Tinkerforge/multi-touch-bricklet/hardware/multi-touch-schematic.pdf

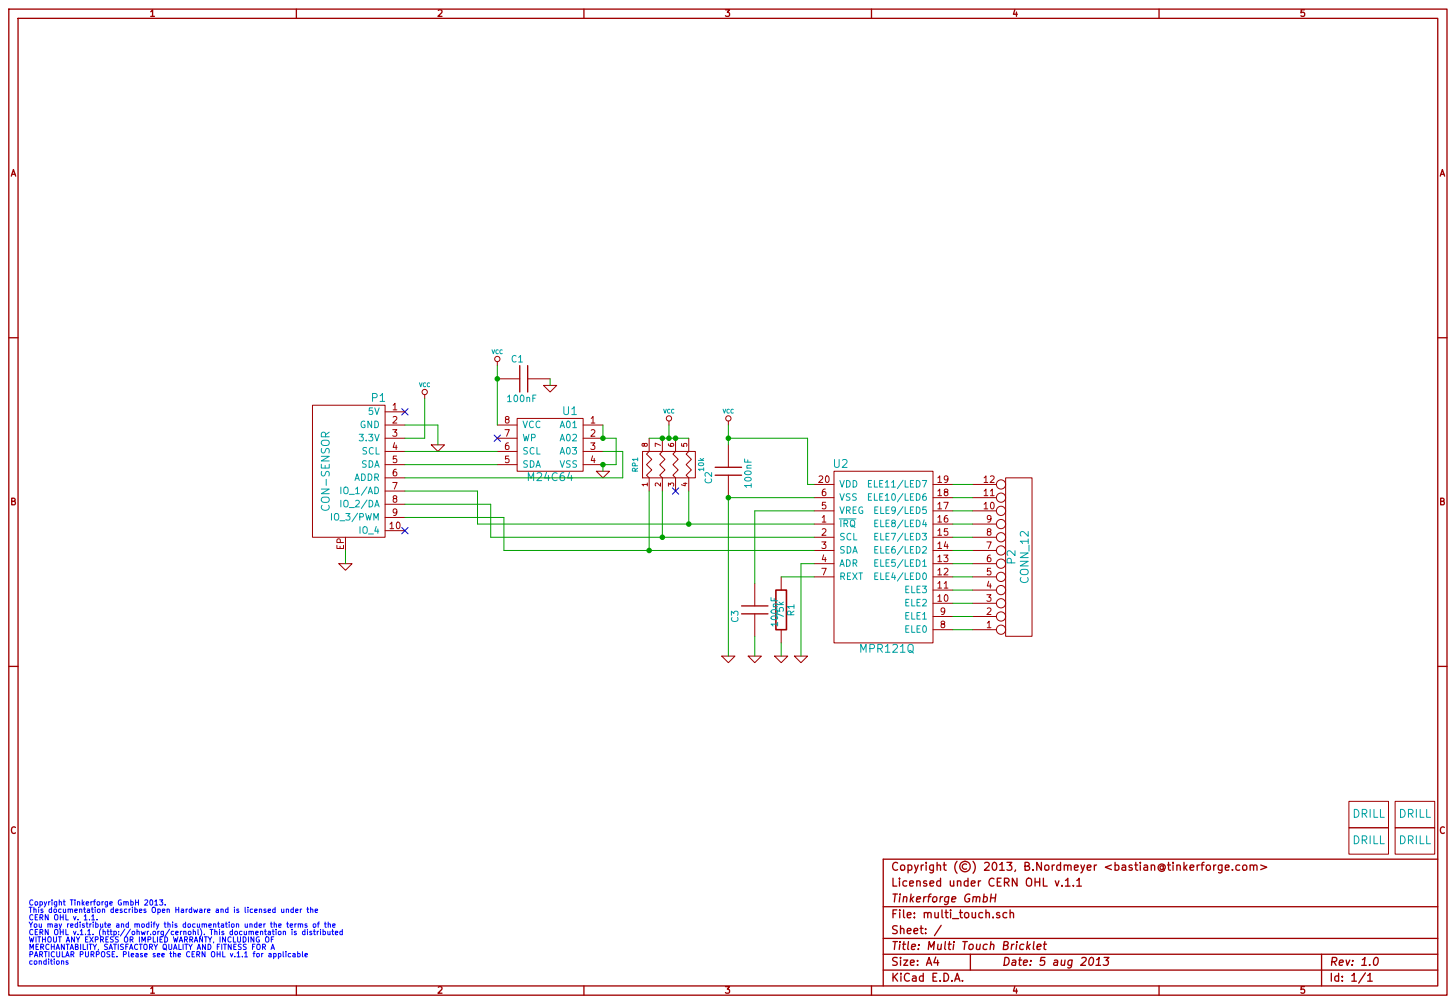
[picture p3: page 1]

VCC Copyright Tinkerforge GmbH 2013. This documentation describes Open Hardware and is licensed under the CERN OHL v. 1.1. You may redistribute and modify this documentation under the terms of the CERN OHL v.1.1. (http://ohwr.org/cernohl). This documentation is distributed WITHOUT ANY EXPRESS OR IMPLIED WARRANTY, INCLUDING OF MERCHANTABILITY, SATISFACTORY QUALITY AND FITNESS FOR A

Copyright (©) 2013, B.Nordmeyer <bastian@tinkerforge.com>
Licensed under CERN OHL v.1.1
Tinkerforge GmbH
Id: 1/1 Title: Multi Touch Bricklet File: multi_touch.sch
Sheet: /

PARTICULAR PURPOSE. Please see the CERN OHL v.1.1 for applicable
