Tinkerforge/multi-touch-bricklet/hardware/multi-touch.kicad_pcb

## KiCad design hardware/multi-touch.kicad_pcb (2017-12-12)

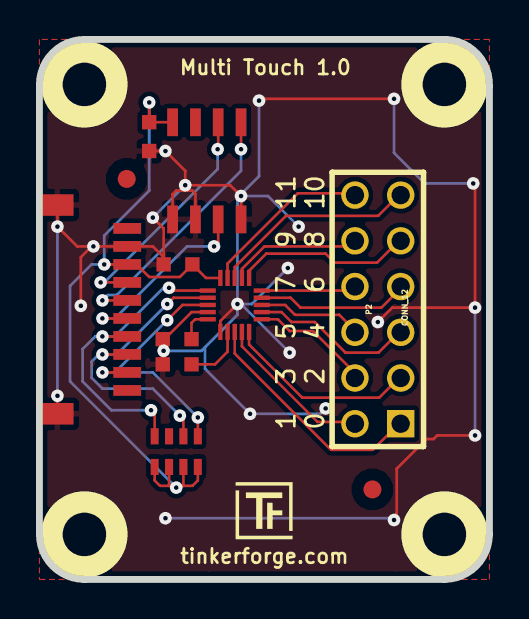
[picture p4: board multi-touch.kicad_pcb from above]

Board: 2 copper layers, 25.0 x 30.0 mm, 17 parts (0 on the bottom side), 22 nets.

Parts:
C1, C2, C3: 100nF; C0603
Fiducial_Mark: VAL**; Fiducial_Mark
Fiducial_Mark#2: VAL**; Fiducial_Mark
P1: CON-SENSOR
P2: CONN_12; pin_array_6x2
R1: 75k; R0603
RP1: 10k; 0603X4
U1: M24C64; SOIC8
U2: MPR121Q; QFN20-3X3
U3, U4, U5, U6: DRILL; DRILL_NP
VAL: WEEE_7mm
VAL#2: CE_5mm

Connections:
GND: C1.2, C2.1, C3.1, P1.2, P1.EP, R1.2, U1.1, U1.2, U1.4, U2.4, U2.6
unnamed: C3.2, U2.5
unnamed: P1.4, U1.6
unnamed: P1.5, U1.5
unnamed: P1.6, U1.3
unnamed: P1.7, RP1.4, U2.1
unnamed: P1.8, RP1.2, U2.2
unnamed: P1.9, RP1.1, U2.3
unnamed: P2.1, U2.8
unnamed: P2.2, U2.9
unnamed: P2.3, U2.10
unnamed: P2.4, U2.11
unnamed: P2.5, U2.12
unnamed: P2.6, U2.13
unnamed: P2.7, U2.14
unnamed: P2.8, U2.15
unnamed: P2.9, U2.16
unnamed: P2.10, U2.17
unnamed: P2.11, U2.18
unnamed: P2.12, U2.19
unnamed: R1.1, U2.7
VCC: C1.1, C2.2, P1.3, RP1.5, RP1.6, RP1.7, RP1.8, U1.8, U2.20
