Tinkerforge/multi-touch-bricklet/(commit log)

2013-07-31 Add prototype disclaimer to readme
2013-08-30 Add API to enable/disable electrodes and recalibration
2013-10-15 add hardware
    [multi_touch.kicad_pcb, multi_touch.sch]
2014-04-02 perl: Unify print style
2015-08-07 Use full device class name in Python examples
2015-09-25 drc run, change drills to np
    [multi_touch.kicad_pcb]
2015-09-25 fix fiducials
    [multi_touch.kicad_pcb]
2016-05-18 c: Add missing device destroy call
2017-12-12 Add 3d information
    [multi_touch.kicad_pcb, multi_touch.sch]
2018-02-20 Cleanup KiCad libraries config
    Ensure LibDir=kicad-libraries and LibName1=tinkerforge.
    Remove special library.
2018-05-11 Rename files
    [multi-touch.kicad_pcb, multi-touch.sch]
2019-03-11 fixed library and schematic
    [multi-touch.sch]
2020-04-07 examples: rust: Print result string.
2021-10-25 Update KiCad link
    https://www.kicad.org/blog/2021/10/Avoid-links-to-former-kicad-domain/
